tom42530/zb-bsb/doc/zb-bsb-enclosure_full.3mf

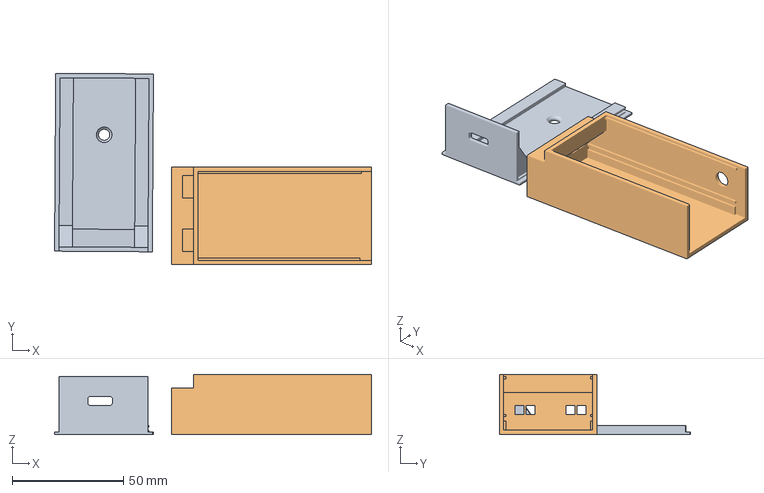
[picture p6: CAD file, 2026-11-08]
doc/zb-bsb-enclosure_full.3mf
142.5 x 86.1 x 27.0 mm
zb-bsb-enclosure-cover
zb-bsb-enclosure
