tom42530/zb-bsb/(commit log)

2026-10-29 feat: initial release of ZB-BSB Zigbee 3.0 bridge for BSB heat pumps
2026-11-01 feat(rf): add Zigbee OnOff switch on EP7 for dynamic external U.FL antenna selection
2026-11-08 feat(bsb): auto-calibrate and pre-compensate optocoupler TX storage delay + fix RVS21 DHW_MODE field ID
    [main.cpp]
2026-11-08 fix(zigbee): isolate zone heating demand & running state, add RVS21 DHW status codes, and bump OTA to 0x01010004
    [zb_bridge.cpp, zb_bridge.h]
2026-11-08 docs: add Home Assistant device screenshots and overview section in EN/FR READMEs
2026-11-08 docs: add electronic schematic, PCB gerbers, and 3D enclosure sections to READMEs
    [zb-bsb-enclosure_full.3mf]
