tom42530/zb-bsb/(notices)

Notices in the files:
README.md:
License: MIT
